Tjoppen/kicad_demo/1u75.fcstd

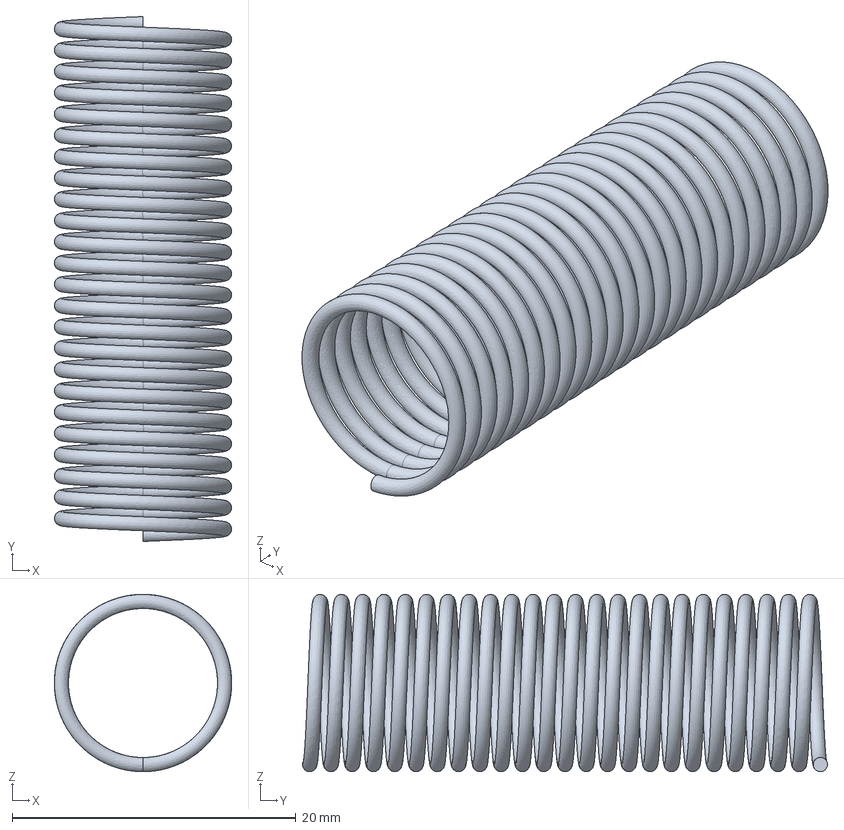
[picture p2: CAD file, 2018-03-25]
1u75.fcstd
12.5 x 37.0 x 12.5 mm
