Tjoppen/kicad_demo/kicad_demo.pdf

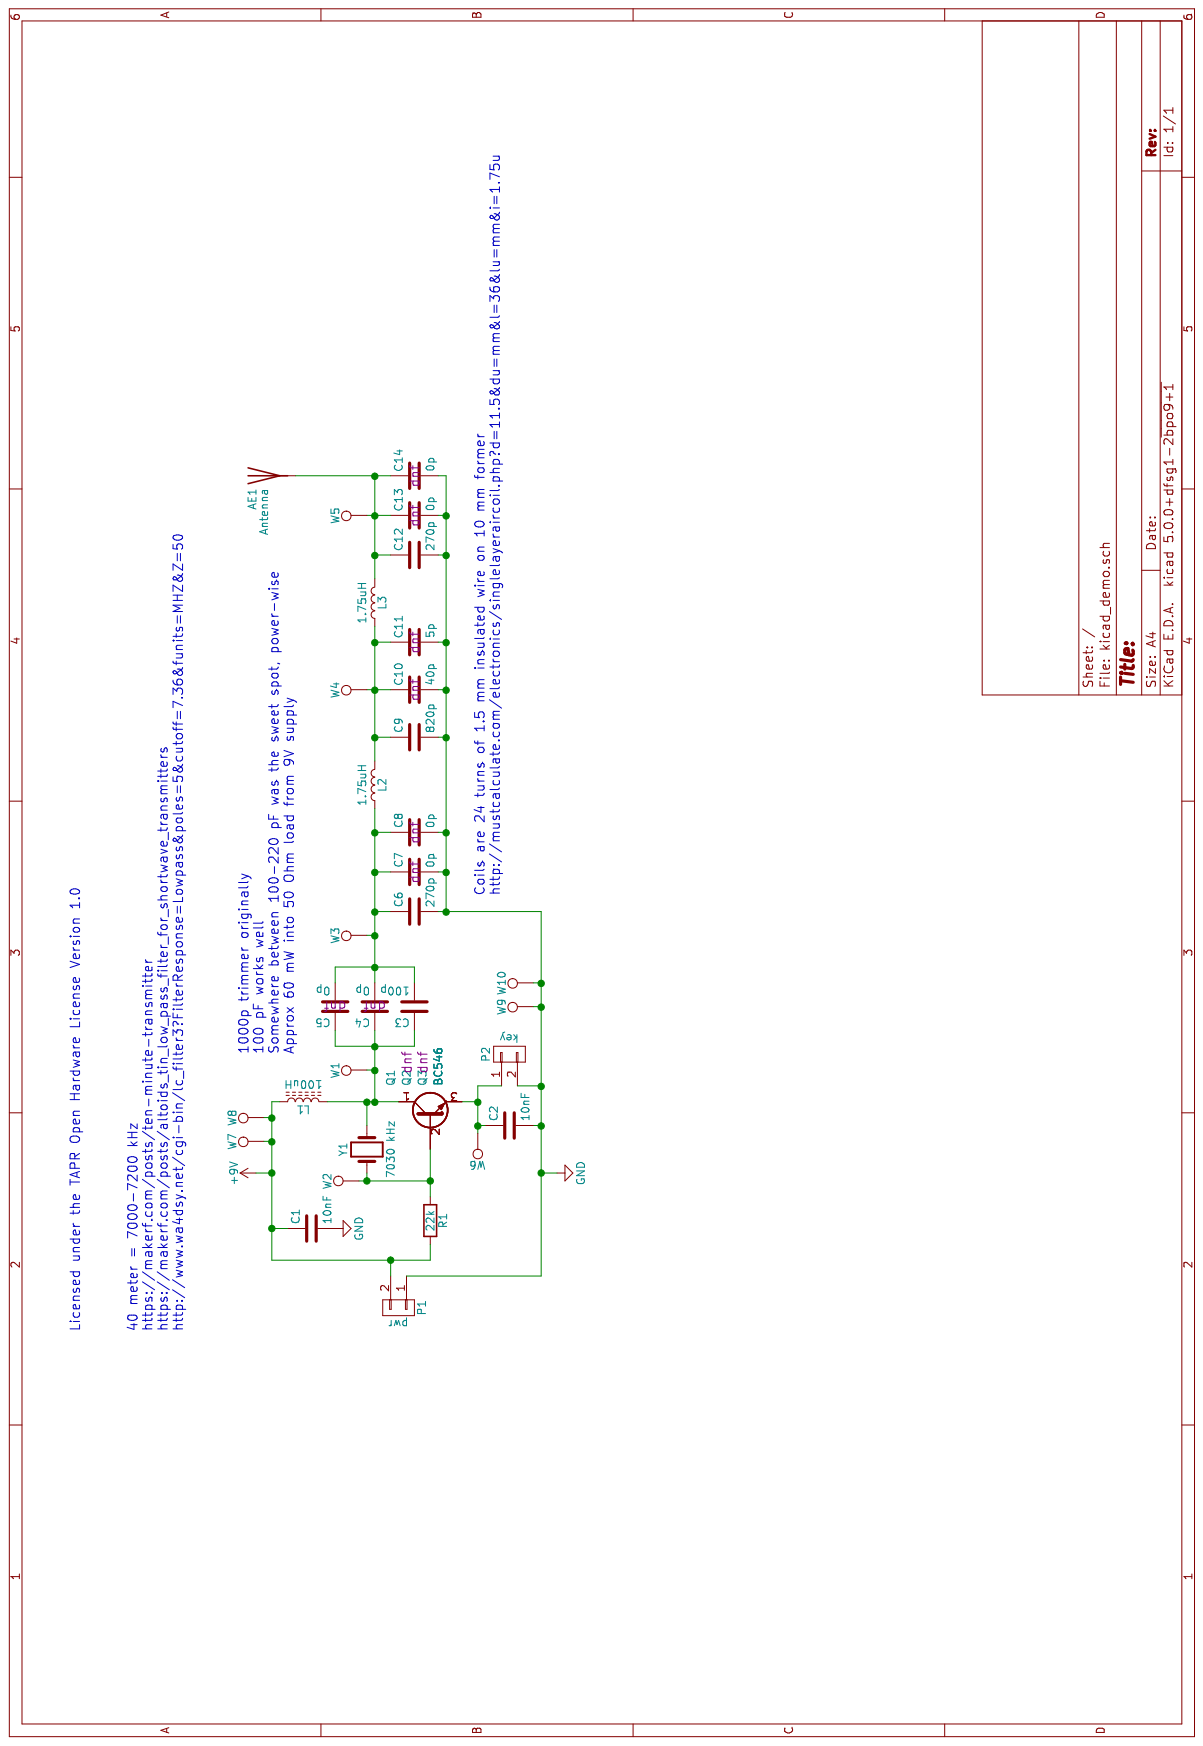
[picture p3: page 1]
