Tjoppen/kicad_demo/kicad_demo.kicad_pcb

## KiCad design kicad_demo.kicad_pcb (2018-05-06)

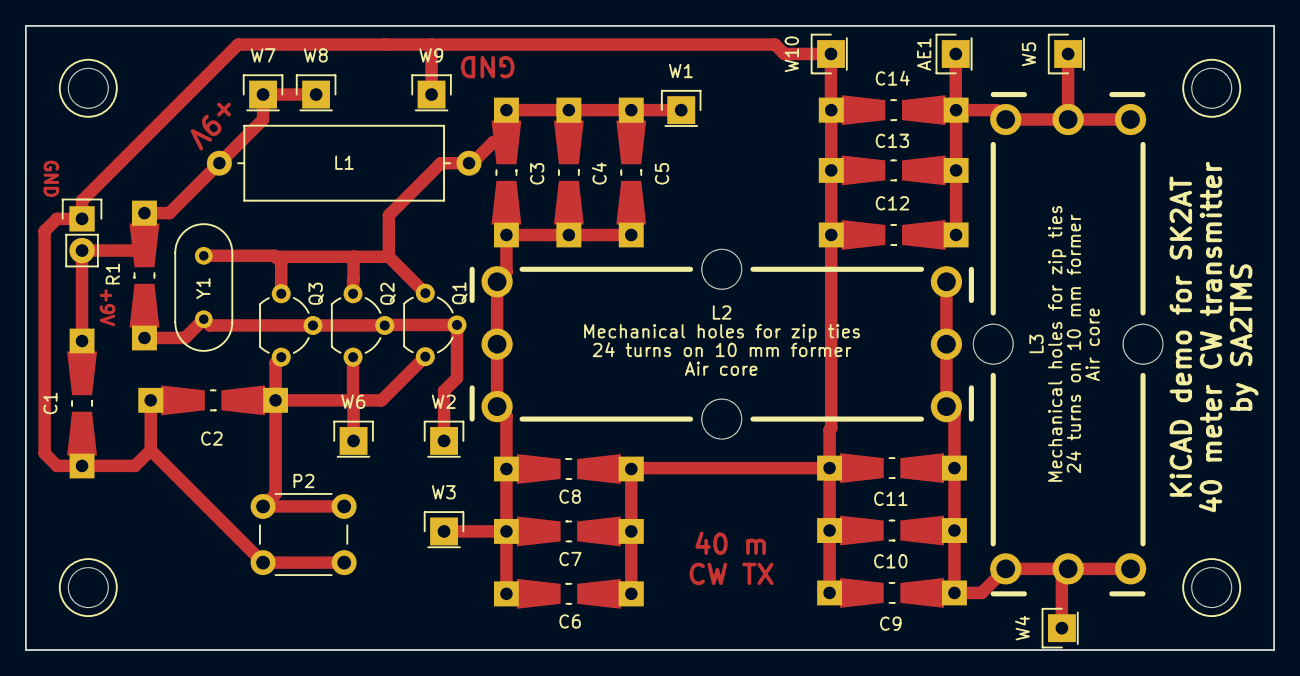
[picture p4: board kicad_demo.kicad_pcb from above]

Board: 2 copper layers, 100.0 x 50.0 mm, 35 parts (0 on the bottom side), 8 nets.

Parts:
AE1: Antenna; Pin_Header_Straight_1x01
C1, C2: 10nF; Resistor_SMD+THTuniversal_0805to1206_RM10_HandSoldering
C3, C4, C5: 100p; Resistor_SMD+THTuniversal_0805to1206_RM10_HandSoldering
C6, C12: 200p; Resistor_SMD+THTuniversal_0805to1206_RM10_HandSoldering
C7, C10, C13: 60p; Resistor_SMD+THTuniversal_0805to1206_RM10_HandSoldering
C8, C14: 7p; Resistor_SMD+THTuniversal_0805to1206_RM10_HandSoldering
C9: 800p; Resistor_SMD+THTuniversal_0805to1206_RM10_HandSoldering
C11: 5p; Resistor_SMD+THTuniversal_0805to1206_RM10_HandSoldering
L1: 100uH; Choke_Horizontal_RM20mm
L2, L3: 1.75uH; 1u75_coil
P1: pwr; Pin_Header_Straight_1x02
P2: key; SW_PUSH_6mm
Q1, Q2, Q3: BC546; TO-92_Molded_Wide
R1: 22k; Resistor_SMD+THTuniversal_0805to1206_RM10_HandSoldering
W1, W2, W3, W4, W5, W6, W7, W8, W9, W10: TEST_1P; Pin_Header_Straight_1x01
Y1: 7020 kHz; HC-49V

Connections:
+9V: C1.1, L1.1, P1.2, R1.2, W7.1, W8.1
GND: C1.2, C2.2, C6.2, C7.2, C8.2, C9.2, C10.2, C11.2, C12.2, C13.2, C14.2, P1.1, P2.2, W9.1, W10.1
unnamed: AE1.1, C12.1, C13.1, C14.1, L3.2, W5.1
unnamed: C2.1, P2.1, Q1.3, Q2.3, Q3.3, W6.1
unnamed: C3.1, C4.1, C5.1, L1.2, Q1.1, Q2.1, Q3.1, W1.1, Y1.2
unnamed: C3.2, C4.2, C5.2, C6.1, C7.1, C8.1, L2.1, W3.1
unnamed: C9.1, C10.1, C11.1, L2.2, L3.1, W4.1
unnamed: Q1.2, Q2.2, Q3.2, R1.1, W2.1, Y1.1
