Tjoppen/kicad_demo/(commit log)

2018-01-25 Ten minute transmitter KiCAD demo
    [kicad_demo.kicad_pcb, kicad_demo.sch]
2018-03-14 Make schematic + part selection more real-world friendly
    Hand-wound air coils w/ custom footprint
    [kicad_demo.sch]
2018-03-14 Rough layout
    Want to route signal and GND on top to minimize current loop size
    [kicad_demo.kicad_pcb, kicad_demo.sch]
2018-03-14 Mostly done
    [kicad_demo.kicad_pcb]
2018-03-14 New pic
    optipng -keep -o7 -zm1-9 kicad_demo.png
2018-03-15 Fiddle with layout, add more transistors
    Vertically centered L2 wrt L3, to reduce coupling.
    Increased distance between signal and GND trace.
    Added two copies of Q1 next to it, in case more power is wanted.
    [kicad_demo.kicad_pcb, kicad_demo.sch]
2018-03-15 Regenerate gerbers according to seeedstudio requirements
    [kicad_demo.kicad_pcb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]
2018-03-16 Add test points, winding instruction on F.SilkS
    [kicad_demo.kicad_pcb, kicad_demo.sch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]
2018-03-18 License under TAPR Open Hardware License Version 1.0
    [kicad_demo.kicad_pcb, kicad_demo.sch]
2018-03-18 Add some useful power test points
    [kicad_demo.kicad_pcb, kicad_demo.sch]
2018-03-18 New gerbers
    [kicad_demo-Edge.Cuts.gm1, kicad_demo-F.Cu.gtl, kicad_demo-F.Mask.gts, kicad_demo-F.SilkS.gto, kicad_demo.drl]
2018-03-19 svg's describing the cnc plans for milling pcb.
2018-03-22 Final version, hopefully
    [kicad_demo.kicad_pcb, kicad_demo.sch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]
2018-03-24 Removed old pcb2gcode output
2018-03-24 pcb2gcode output.
2018-03-24 Scripts with options used to convert from gerber.
2018-03-25 Add 3D model for 1u75 coils
    [1u75.fcstd]
2018-03-25 3D coil in PCB
    [kicad_demo.kicad_pcb]
2018-05-06 Generate bottom copper too
    [kicad_demo.kicad_pcb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]
2018-05-15 Mouser BOM
    [kicad_demo.sch, kicad_demo_.csv]
2018-09-14 Upgrade to KiCAD 5.0.0
    [kicad_demo.sch]
2018-09-25 Some folks at SK2AT wanted a PDF of the schematic
