Tjoppen/kicad_demo/(notices)

Notices in the files:
kicad_demo.kicad_pcb:
Licensed under the TAPR Open Hardware License Version 1.0
